thanh01pmt/Alphabot/HW/Alphabot 2.pptx

## Alphabot 2.0

By Melvin & Noah

## Slide 2

Schnupperlehrvariante / Grundbestückung

Speisung
- Powerboost
- Batterie
- Power ON LED
- ON/OFF Switch

Kontrolleinheit
ESP32 / Arduino Nano

Motor
- Motor
- Treiber
- Räder
- Stromregelung

Input
- IR-Linienfolger
- (IR-Distanz)
- (Endschalter)
- (Ultraschall)

= Grundbestückung

Output
- Test-Led
- Bodenbeleuchtung WS2812B
- («Mund»)

Extra
- 4x7 Matrix
- 5 Taster

= Optional

= Extra

## Slide 3

Fortgeschritten

Taster
3 Stk.

Piezo

Auto
Grundbestückung

Display

Bewegung
ICM-20948

ESP32 CAM

Helligkeit

DIP-Switch
8-Fach

Witterung

= Outputs

= Inputs

= I/O

Sensoren

## Slide 4

Skizze

«Mund»

Endschalter

Endschalter

ESP32

Nano

Display

Treiber

Motor

ICM

Motor

Ladelogik

## Slide 5

Website Auto

CAMx.local

Alphabot 2.0 Control

Camera Stream

Debug Messages

Joystick

X

## Slide 6
