thanh01pmt/Alphabot/HW/Blockdiagramm.pptx

Test-LED

IR-Empfänger

Lichtsensor

WS2812b

Batterie

Piezo

Ultraschall

Umgebung

USB

Speisung

ATmega

I2C

Bewegung

Voltage Translator

USB to UART

Wroom

UART

Serial

Lichtsensor

IR-Empfänger

Test-LED

I/O Expander 1

Taster

IR-Sender

I/O

DIP-Switch

SPI

I/O Expander 2

Motor

Speisung

Low-Bat

Mund/ Endschalter
