thanh01pmt/Alphabot/HW/Blockschaltbild.docx

Data/Wire

Data/Wireless

Power

Joystick

Data

Data

Data

Data

Inputs

Outputs

Joystick

Data

Data

3.3V

3.3V

5V

ESP32 CAM

Website

Stream

Websocket

Steuerung

(Handy / Fernbedienung)

5V

3.7V

IO

ESP32

Websocket

Powerboost

Micro-USB

Lipo Batterie

3.3V Wandler

Motortreiber

Links

Motortreiber

Rechts

Motor Rechts

Motor Links

Blockdiagramm Alphabot 2.0
