thanh01pmt/Alphabot/HW/Einkaufen/Einkaufen.docx

Einkaufen

https://www.dfrobot.com/product-1558.html?search=wheel&description=true&page=3
