thanh01pmt/Alphabot/HW/Einkaufen/OLED_Display.docx

https://www.christians-shop.de/096-OLED-Display-128-x-64-SH1106-I2C-IIC-weiss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

https://www.bastelgarage.ch/oled-display-blau-i2c-128x64-0-96

https://www.makershop.de/display/oled/096-zoll-oled-ssd1306/
