thanh01pmt/Alphabot/HW/Einkaufen/Teure Teile Powerboost.docx

Teure Teile Powerboost

Booster:

https://www.mouser.ch/ProductDetail/Texas-Instruments/TPS61090RSAR?qs=Gse6rAGbi7%2FbGTQiY2PrFA%3D%3D

Battery Management

https://www.mouser.ch/ProductDetail/Microchip-Technology/MCP73871-2CCI-ML?qs=qXsUupcbpXyQfJ2clznZxw%3D%3D

Spule:

https://www.digikey.ch/product-detail/de/bourns-inc/SRN6045-6R8Y/SRN6045-6R8YCT-ND/2756162

Batterieanschluss:

https://www.distrelec.ch/de/stiftleiste-pole-jst-s2b-ph-sm4-tb-lf-sn/p/30021720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

Micro USB:

https://www.digikey.ch/product-detail/de/629105150521/732-5960-1-ND/5047555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

NTC Widerstand:

https://www.mouser.ch/ProductDetail/TDK/NTCG203NH103JTDS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
