thanh01pmt/Alphabot/Kommunikation/CAM Website/Blockdiagramm_CAMWebsite.docx

BLE

Handy3

Handy2

Handy1

Master Handy

ESP-CAM2

ESP-CAM3

ESP-CAM1

Master ESP

Auto1 ESP

Auto2 ESP

Auto3 ESP

UART

WLAN Raspi

Master Website (WLAN)

Website1 (WLAN)

Website2 (WLAN)

Website3 (WLAN)

SPI

Blockdiagramm CAM Webseite
