thanh01pmt/Alphabot/Kommunikation/CAM Website/CAM Webseite.docx

CAM Webseite

Handy

- Verbindet sich mit WLAN Raspi (QR-Code)
- Verbindet sich mit ESP-CAM Website
  - Bekommt Kamerastream
  - Schickt Infos zum ESP-CAM

Auto ESP

- Steuert das Auto
- Schickt Status per BLE zum Master ESP
- Bekommt Infos von:
  - Master ESP (BLE)
  - ESP-CAM (UART)
  - Sensoren

ESP-CAM

- Website
  - Stream
  - Steuerung
- UART zu Auto ESP
  - Infos von Website
  - Infos für Website

Master Handy

- Verbindet sich mit WLAN Raspi (QR-Code)
- Schickt WLAN Raspi Infos für Master ESP
- Bekommt Infos von Master ESP über WLAN Raspi

Master ESP

- Bekommt Infos per BLE von Auto ESP
- Schickt Infos per BLE zu Auto ESP
- Bekommt Infos per SPI von WLAN Raspi
- Schickt Infos per SPI zu WLAN Raspi

WLAN Raspi

- Access Point für Handy zu CAM Kommunikation (Webseite)
- Master Webseite
  - Steuerung von Master Handy zu Master ESP über WLAN Raspi
  - Status von Master ESP zu Master Handy über WLAN Raspi
- SPI zu Master ESP
  - Infos von Website
  - Infos für Website
