thanh01pmt/Alphabot/Kommunikation/CAM WLAN 2/Blockdiagramm_CAMWLAN_V2.docx

Master Handy

Handy3

Handy2

ESP-CAM2

Auto2 ESP

Master ESP

BLE

ESP-CAM3

UART

Auto3 ESP

Handy1

ESP-CAM1

Auto1 ESP

Website1 (WLAN, auf ESP-CAM1)

WLAN ESP

Website2 (WLAN, auf ESP-CAM2)

Website3 (WLAN, auf ESP-CAM3)

Master Website (WLAN)

SPI

Blockdiagramm CAM WLAN V2
