thanh01pmt/Alphabot/Kommunikation/CAM WLAN 2/CAM WLAN V2.docx

CAM WLAN V2

Master ESP

- Bekommt Infos per BLE von Auto ESP
- Schickt Infos per BLE zu Auto ESP
- Bekommt Infos per SPI von WLAN ESP
- Schickt Infos per WLAN zu WLAN ESP

ESP-CAM

- Website
  - Stream
  - Steuerung
- WLAN Hotspot
- UART zu Auto ESP
  - Infos von Website
  - Infos für Website

Handy

- Verbindet sich mit WLAN ESP-CAM (QR-Code)
- Verbindet sich mit ESP-CAM Website
  - Bekommt Kamerastream
  - Schickt Infos zum ESP-CAM

Auto ESP

- Steuert das Auto
- Schickt Status per BLE zum Master ESP
- Bekommt Infos von:
  - Master ESP (BLE)
  - ESP-CAM (UART)
  - Sensoren

WLAN ESP

- Hotspot für Master Handy Kommunikation (Master Webseite)
- Master Webseite
  - Steuerung von Master Handy zu Master ESP über WLAN ESP
  - Status von Master ESP zu Master Handy über WLAN ESP
- SPI zu Master ESP
  - Infos von Website
  - Infos für Website

Master Handy

- Verbindet sich mit WLAN ESP (QR-Code)
- Schickt über WLAN ESP Infos für Master ESP
- Bekommt Infos von Master ESP über WLAN ESP
