thanh01pmt/Alphabot/Kommunikation/CAM WLAN 3/Blockdiagramm_CAMWLAN_V3_Controller.docx

Master Handy

Auto2 ESP

BLE Ev nur Master ESP

UART

Auto1 ESP

WLAN Auto

ESP-CAM2

WLAN ESP

WLAN Controller

Master Website (WLAN)

SPI

HM-18 2.1

Master ESP

ESP-CAM1

WLAN Bildschirm1 (ESP01, Handy)

HM-18 2.2

HM-18 1.2

HM-18 1.1

WLAN Bildschirm2(ESP01, Handy)

Blockdiagramm CAM WLAN V3 Controller
