thanh01pmt/Alphabot/Kommunikation/CAM WLAN 3/Blockdiagramm_CAMWLAN_V3_Handy.docx

Master Handy

Master ESP

BLE

UART

HM-18

Website1 (WLAN, auf ESP-CAM1)

WLAN ESP

Website2 (WLAN, auf ESP-CAM2)

Master Website (WLAN)

SPI

Auto2 ESP

Ev nur Master ESP

Handy2

ESP-CAM2

Handy1

ESP-CAM1

HM-18

Auto1 ESP

Auto

Blockdiagramm CAM WLAN V3 Handy
