thanh01pmt/Alphabot/Kommunikation/CAM WLAN 3/CAM WLAN V3 Handy.docx

CAM WLAN V3 Handy

Auto ESP

- Steuert das Auto
- Schickt Status zum HM18 (Master ESP)
- Bekommt Infos von:
  - HM18 (UART, Master ESP)
  - ESP-CAM (WLAN)
  - Handy (WLAN)
  - Sensoren

Master Handy

- Verbindet sich mit WLAN ESP (QR-Code)
- Schickt über WLAN ESP Infos für Master ESP
- Bekommt Infos von Master ESP über WLAN ESP

Master ESP

- Bekommt Infos per BLE von HM18 (von Auto ESP)
- Schickt Infos per BLE zu HM18 (zu Auto ESP)
- Bekommt Infos per SPI von WLAN ESP
- Schickt Infos per SPI zu WLAN ESP

ESP-CAM

- Website
  - Stream
  - Steuerung

HM18

- Bekommt Infos von Auto ESP (UART) zu Master ESP (BLE)
- Bekommt Infos von Master ESP (BLE) zu Auto ESP (UART

WLAN ESP

- Hotspot für Master Handy Kommunikation (Master Webseite)
- Master Webseite
  - Steuerung von Master Handy zu Master ESP über WLAN ESP
  - Status von Master ESP zu Master Handy über WLAN ESP
- SPI zu Master ESP
  - Infos von Website
  - Infos für Website

Handy

- Verbindet sich mit WLAN (QR-Code)
- Verbindet sich mit Website
  - Bekommt Kamerastream
  - Schickt Infos für das Auto
  - Bekommt Infos vom Auto
