thanh01pmt/Alphabot/Kommunikation/CAM WLAN/Blockdiagramm_CAMWLAN.docx

Handy3

Handy2

ESP-CAM2

Auto2 ESP

Master Handy

Master ESP

BLE

ESP-CAM3

UART

Auto3 ESP

Handy1

ESP-CAM1

Auto1 ESP

Website1 (WLAN, auf ESP-CAM1)

Website2 (WLAN, auf ESP-CAM2)

Website3 (WLAN, auf ESP-CAM3)

Master Website (WLAN)

Blockdiagramm CAM WLAN
