thanh01pmt/Alphabot/Kommunikation/CAM WLAN/CAM WLAN.docx

CAM WLAN

Master ESP

- Bekommt Infos per BLE von Auto ESP
- Schickt Infos per BLE zu Auto ESP
- Bekommt Infos per WLAN von Master Handy
- Schickt Infos per WLAN zu Master Handy
- WLAN Hotspot

ESP-CAM

- Website
  - Stream
  - Steuerung
- WLAN Hotspot
- UART zu Auto ESP
  - Infos von Website
  - Infos für Website

Handy

- Verbindet sich mit WLAN ESP-CAM (QR-Code)
- Verbindet sich mit ESP-CAM Website
  - Bekommt Kamerastream
  - Schickt Infos zum ESP-CAM

Auto ESP

- Steuert das Auto
- Schickt Status per BLE zum Master ESP
- Bekommt Infos von:
  - Master ESP (BLE)
  - ESP-CAM (UART)
  - Sensoren

Master Handy

- Verbindet sich mit WLAN Master ESP (QR-Code)
- Schickt über WLAN Master ESP Infos für Master ESP
- Bekommt Infos von Master ESP über WLAN Master ESP
