thanh01pmt/Alphabot/Kommunikation/QR-Codes/QR-Codes.docx

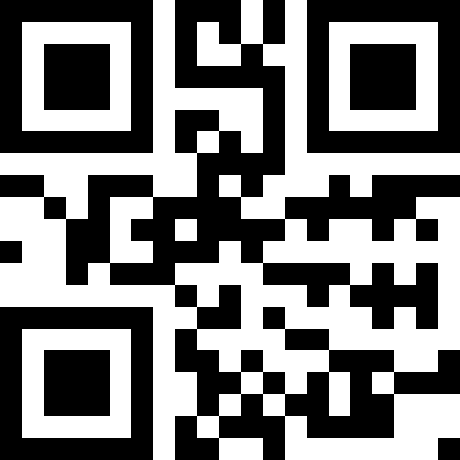
[picture p1: figure]
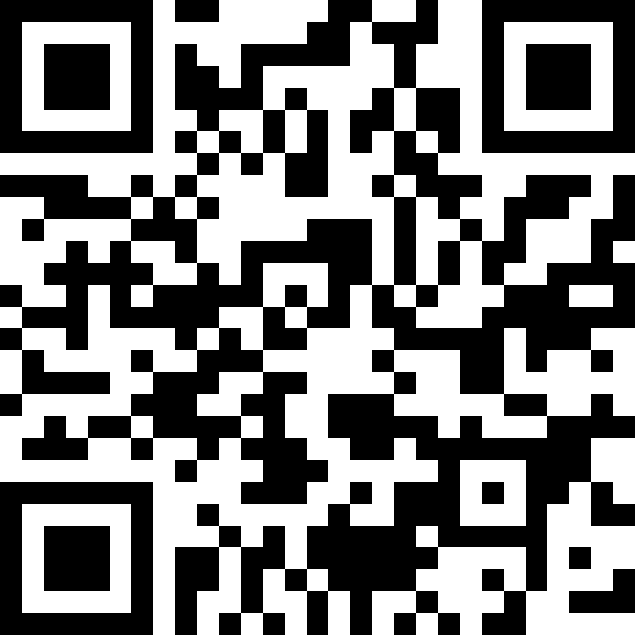
[picture p2: figure]

Wlan: EL-Parcour IP-Adresse Raspberry Pi
