thanh01pmt/Alphabot/Kommunikation/CODE/AUTO/Ablauf.docx

1. Includes
2. Defines
3. Variabeln
4. Initialisierung
5. Funktionen
  a. Motor
  b. convertString
  c. websocket
  d. farbe
  e. convert UDP
6. Setup
  a. Serial.begin
  b. Wifi
  c. Mdns
  d. Rest initialisierung
  e. pinMode
  f. UDP «void»
    i. Call convert UDP
  g. Multicast «i’m here»
  h. Bekommt unicast «Auto x»
  i. Call farbe
7. Loop
  a. Call Motor
  b. Show
  c. …
