thanh01pmt/Alphabot/HW/Datasheets/Pinbelegung_ESP_.PNG

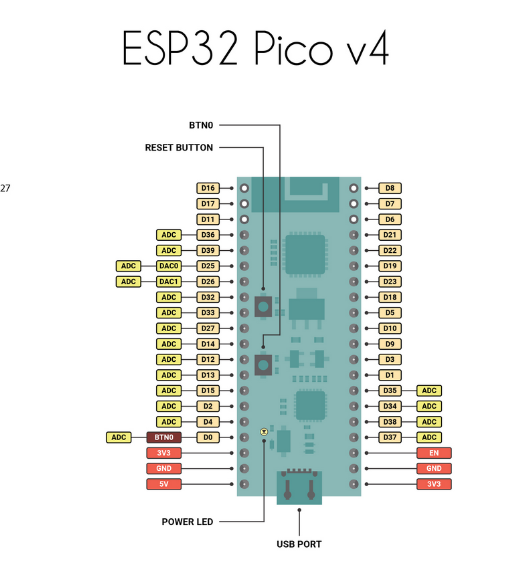
HW/Datasheets/Pinbelegung_ESP_.PNG
