thanh01pmt/Alphabot/HW/Einkaufen/Einkaufen.xlsx

Bestellungen
Bauteil | Art-Nr | Lieferant | Bezeichnung | Preis | Stückzahl | Link
Motor | FIT0579 | dfrobot | DFRobot Micro Metal DC Geared Motor | 7.21 | 14 | https://www.dfrobot.com/product-1736.html?search=fit0579&description=true
Motorhalterung | FIT0160 | dfrobot | Micro Metal Gearmotor Bracket | 3.36 | 7 | https://www.dfrobot.com/product-510.html?search=fit0160&description=true
Räder | FIT0494 | dfrobot | N20 ABS Rubber Wheel 43x9mm | 3.36 | 7 | https://www.dfrobot.com/product-1558.html?search=wheel&description=true&page=3
ESP-32 pico kit | 356-ESP32-PICO-KIT | mouser | WLAN Development Tools | 9.77 | 5 | https://www.mouser.ch/ProductDetail/Espressif-Systems/ESP32-PICO-KIT
Motortreiber | 474-ROB-14451 | mouser | MotorDriver Dual TB6612FNG | 4.84 | 5 | https://www.mouser.ch/ProductDetail/SparkFun/ROB-14451
Powerboost | Powerboost | mouser | PowerBoost 500 Recharge 5V Lipo | 14.62 | 5 | https://www.mouser.ch/ProductDetail/Adafruit/1944
Batterie | 420334 | bastelgarage | LiPo Akku 1500mAh | 10.5 |  | https://www.bastelgarage.ch/lipo-akku-1500mah-jst-2-0-lithium-ion-polymer
WS2812b
IR-Sensor | 11044-350 | distrelec | Reflex coupler | 0.83 | 10 | https://www.distrelec.ch/en/reflex-coupler-30-thd-940-nm-everlight-electronics-itr20001/p/11044350
ON/OFF 2.54 | 485-805 | mouser | Breadboard Friendly SPDT Slide Switch | 0.93 | 10 | https://www.mouser.ch/ProductDetail/Adafruit/805
ESP-CAM | DFR0602 | dfrobot | ESP32-CAM Development Board | 9.52 | 5 | https://www.dfrobot.com/search-esp32-cam.html
Endschalter | MB MICROSWITCH B | reichelt | Me Micro Switch B | 3.57 |  | https://www.reichelt.de/makeblock-me-micro-switch-b-mb-microswitch-b-p202095.html
Widerstände THT
Fredy+Claudio Fragen
Stichsäge | 360544 | brack.ch | Akku-Stichsäge PST 18 LI | 199 | 1 | https://www.brack.ch/bosch-akku-stichsaege-pst-18-li-360544
ruhe | 0.4
fahren ohne widerstnd | 0.5
mit R | 0.6
