thanh01pmt/Alphabot/HW/3D-Druck/Vorderrad/Alphabot2_Vorderrad_oben.stl

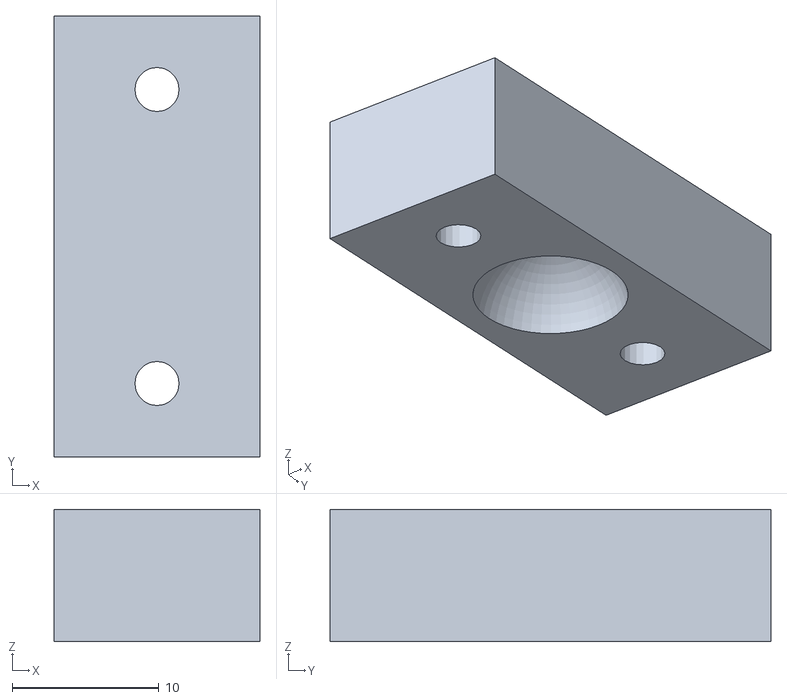
[picture p4: CAD file, 2019-12-18]
HW/3D-Druck/Vorderrad/Alphabot2_Vorderrad_oben.stl
14.0 x 30.0 x 9.00
