thanh01pmt/Alphabot/HW/3D-Druck/Vorderrad/Alphabot2_Vorderrad_unten.stl

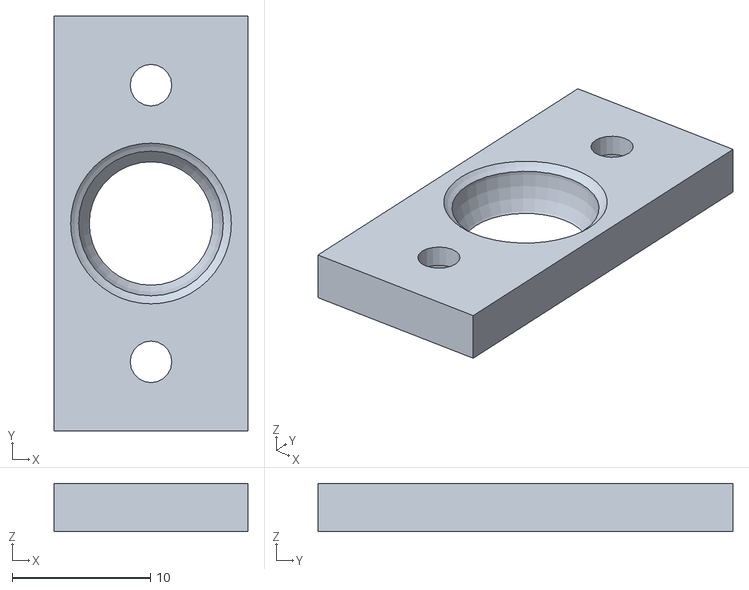
[picture p5: CAD file, 2019-12-18]
HW/3D-Druck/Vorderrad/Alphabot2_Vorderrad_unten.stl
14.0 x 30.0 x 3.50
