thanh01pmt/Alphabot/Kommunikation/Fragen_Problem_Testkriterien.docx

# Fragen/Probleme - Testkriterien:

Cam-Website:

- WLAN Verbindungslimit Raspi?
  - 2 ESP Cams und ein paar andere ESP’s verbinden sich mit dem Raspi Hotspot und simulieren einen starken Datenverkehr, dabei müssen alle Verbindungen aufrechterhalten werden und flüssig bleiben
- ESP Multiconnect?
  - 2 Clients ESP32 Pico Kits kommunizieren mit einem Master ESP32 Wrover Kit über BLE und tauschen verschiedene Daten in beide Richtungen aus
- Raspi WLAN + eigene Website?
  - Hotspot und Apache(Webserver) installieren und die Website über den Hotspot aufrufen
- Kann WLAN Raspi Master ESP ersetzen?
  - Cam Livestream und gleichzeitig BLE Aktivitäten laufen lassen
- Master ESP über BLE oder WLAN?
  - ESP32 WIFI-Cam und Bluetooth Aktivitäten gleichzeitig handeln

Cam-WLAN:

- Gehen 5 WLAN auf kleinstem Raum?
  - Mit ESP’s Hotspots machen und einen starken Datenverkehr simulieren, dabei müssen alle Verbindungen aufrechterhalten werden und flüssig bleiben
- CAM eigener Hotspot und Website?
  - Einen ESP32 Cam programmieren, dass er den Hotspot und die Website gleichzeitig macht
- Auto ESP WLAN und BLE?
  - ESP32 WIFI-Cam und Bluetooth Aktivitäten gleichzeitig handeln
- ESP Multiconnect?
  - 2 Clients ESP32 Pico Kits kommunizieren mit einem Master ESP32 Wrover Kit über BLE und tauschen verschiedene Daten in beide Richtungen aus
