thanh01pmt/Alphabot/(list of files, drawings)

Other design files:
HW/Motorstromüberwachung/Motorstromüberwachung.ms14
