thanh01pmt/Alphabot/HW/Alphabot2.0/Alphabot2.0.kicad_pcb

## KiCad design HW/Alphabot2.0/Alphabot2.0.kicad_pcb (2019-12-18)

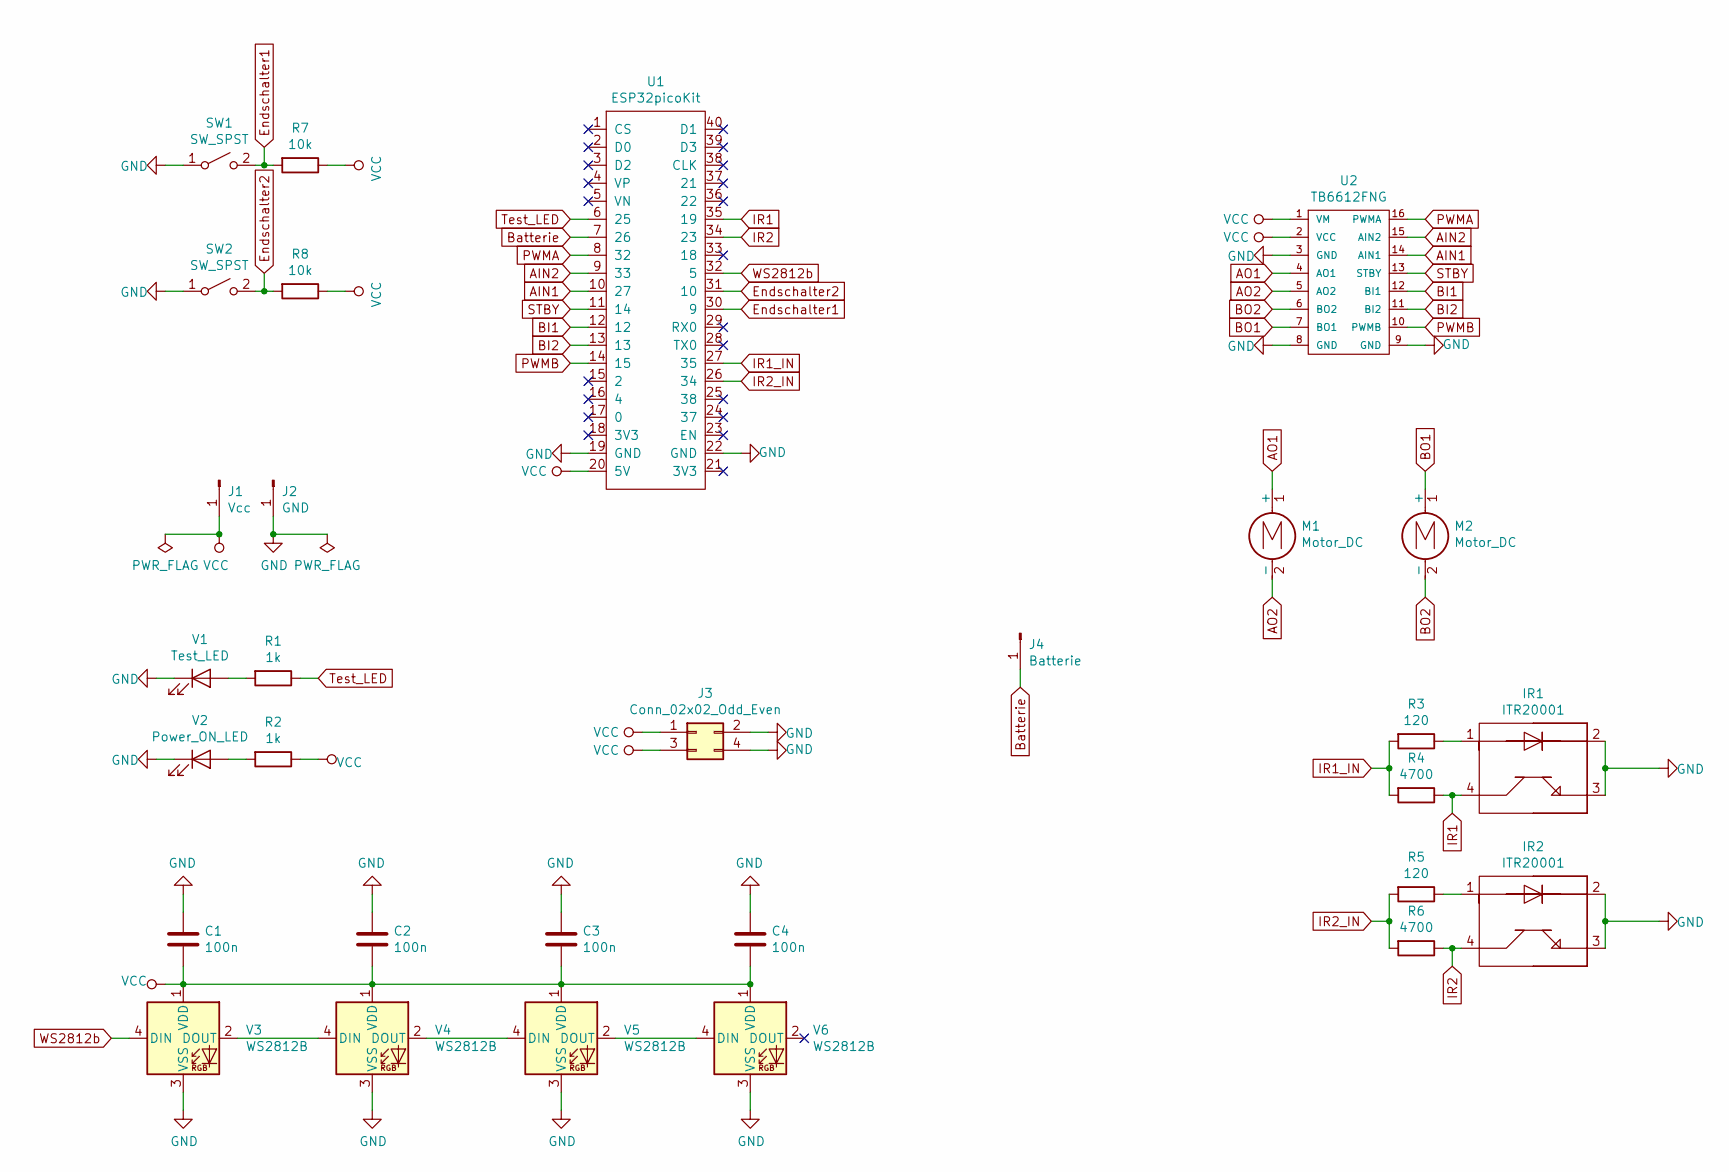
[picture p6: schematic Alphabot2.0.sch, Alphabot2.0]

Parts:
C1, C2, C3, C4: 100n; C_0805_2012Metric_Pad1.15x1.40mm_HandSolder
IR1, IR2: ITR20001; ITR20001-T
J1: Vcc; PinHeader_1x01_P2.54mm_Vertical
J2: GND; PinHeader_1x01_P2.54mm_Vertical
J3: Conn_02x02_Odd_Even; PinHeader_2x02_P2.54mm_Vertical_SMD
J4: Batterie; PinHeader_1x01_P2.54mm_Vertical
M1, M2: Motor_DC; N20_DC_Motor_mit_Halterung
R1, R2: 1k; R_0805_2012Metric_Pad1.15x1.40mm_HandSolder
R3, R5: 120; R_0805_2012Metric_Pad1.15x1.40mm_HandSolder
R4, R6: 4700; R_0805_2012Metric_Pad1.15x1.40mm_HandSolder
R7, R8: 10k; R_0805_2012Metric_Pad1.15x1.40mm_HandSolder
SW1, SW2: SW_SPST; Endschalter
U1: ESP32picoKit; ESP32_Pico_Kit
U2: TB6612FNG
V1: Test_LED; LED_0805_2012Metric_Pad1.15x1.40mm_HandSolder
V2: Power_ON_LED; LED_0805_2012Metric_Pad1.15x1.40mm_HandSolder
V3, V4, V5, V6: WS2812B; LED_WS2812B_PLCC4_5.0x5.0mm_P3.2mm

Connections:
AIN1: U1.10 (27), U2.14 (AIN1)
AIN2: U1.9 (33), U2.15 (AIN2)
AO1: M1.1 (+), U2.4 (AO1)
AO2: M1.2 (-), U2.5 (AO2)
BI1: U1.12, U2.12 (BI1)
BI2: U1.13, U2.11 (BI2)
BO1: M2.1 (+), U2.7 (BO1)
BO2: M2.2 (-), U2.6 (BO2)
Batterie: J4.1, U1.7 (26)
Endschalter1: R7.2, SW1.2 (B), U1.30 (9)
Endschalter2: R8.2, SW2.2 (B), U1.31 (10)
GND: C1.1, C2.1, C3.1, C4.1, IR1.2, IR1.3, IR2.2, IR2.3, J2.1, J3.2, J3.4, SW1.1 (A), SW2.1 (A), U1.19 (GND), U1.22 (GND), U2.3 (GND), U2.8 (GND), U2.9 (GND), V1.1 (K), V2.1 (K), V3.3 (VSS), V4.3 (VSS), V5.3 (VSS), V6.3 (VSS)
IR1: IR1.4, R4.1, U1.35 (19)
IR1_IN: R3.2, R4.2, U1.27 (35)
IR2: IR2.4, R6.1, U1.34 (23)
IR2_IN: R5.2, R6.2, U1.26 (34)
unnamed: IR1.1, R3.1
unnamed: IR2.1, R5.1
unnamed: R1.2, V1.2 (A)
unnamed: R2.2, V2.2 (A)
unnamed: V3.2 (DOUT), V4.4 (DIN)
unnamed: V4.2 (DOUT), V5.4 (DIN)
unnamed: V5.2 (DOUT), V6.4 (DIN)
PWMA: U1.8 (32), U2.16 (PWMA)
PWMB: U1.14 (15), U2.10 (PWMB)
STBY: U1.11 (14), U2.13 (STBY)
Test_LED: R1.1, U1.6 (25)
VCC: C1.2, C2.2, C3.2, C4.2, J1.1, J3.1, J3.3, R2.1, R7.1, R8.1, U1.20 (5V), U2.1 (VM), U2.2 (VCC), V3.1 (VDD), V4.1 (VDD), V5.1 (VDD), V6.1 (VDD)
WS2812b: U1.32 (5), V3.4 (DIN)

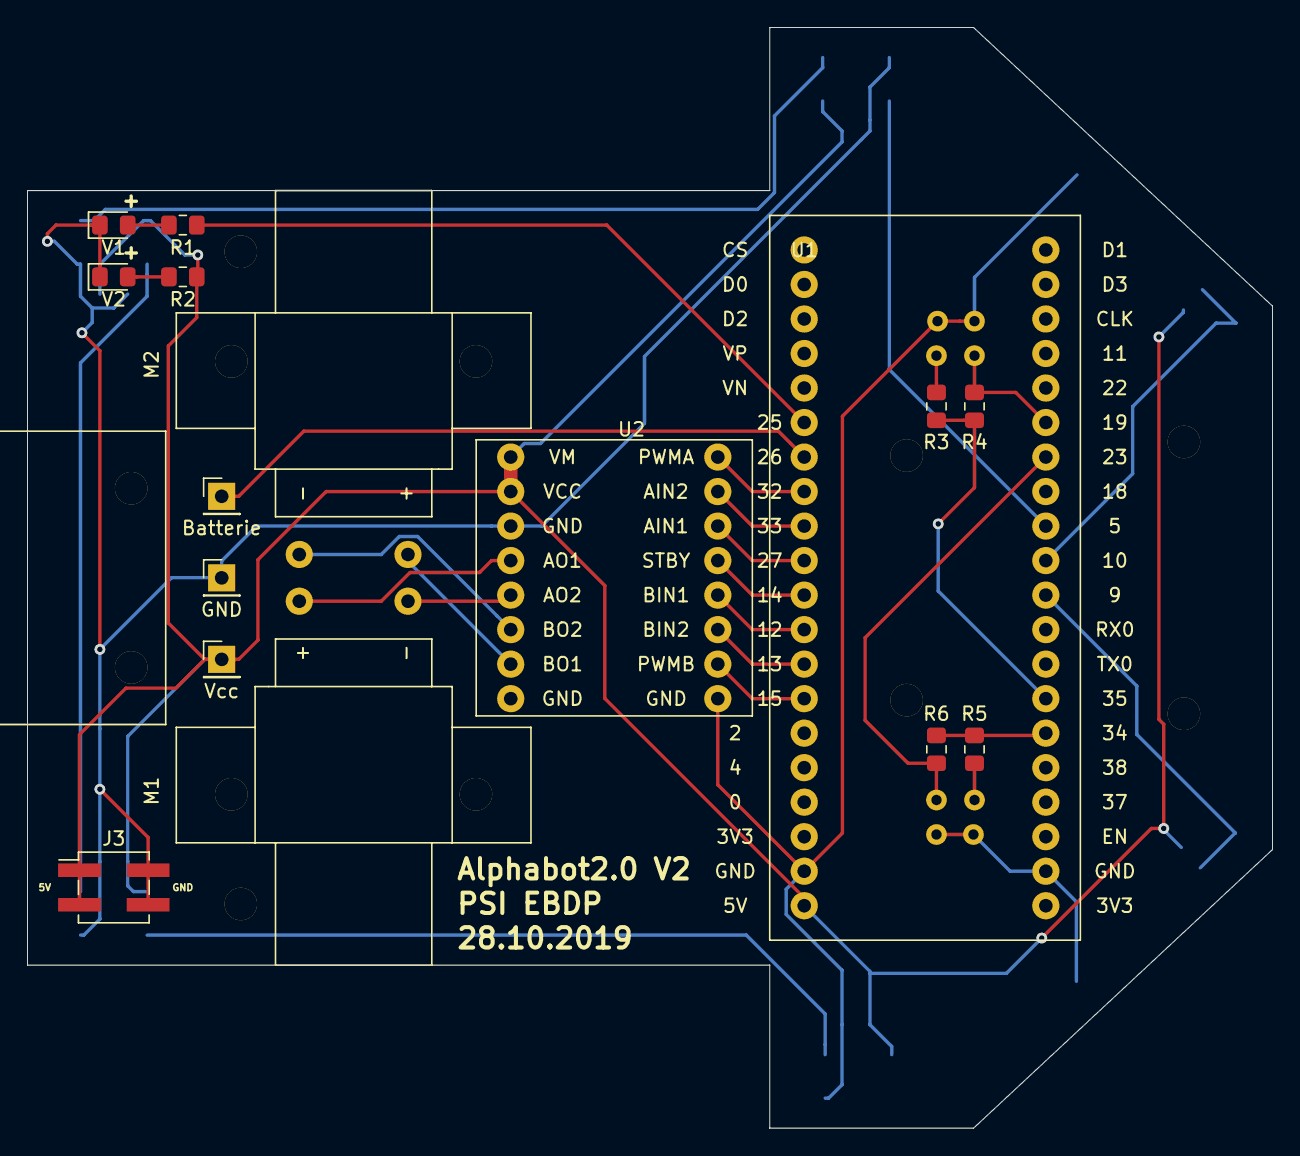
[picture p7: board Alphabot2.0.kicad_pcb from above]

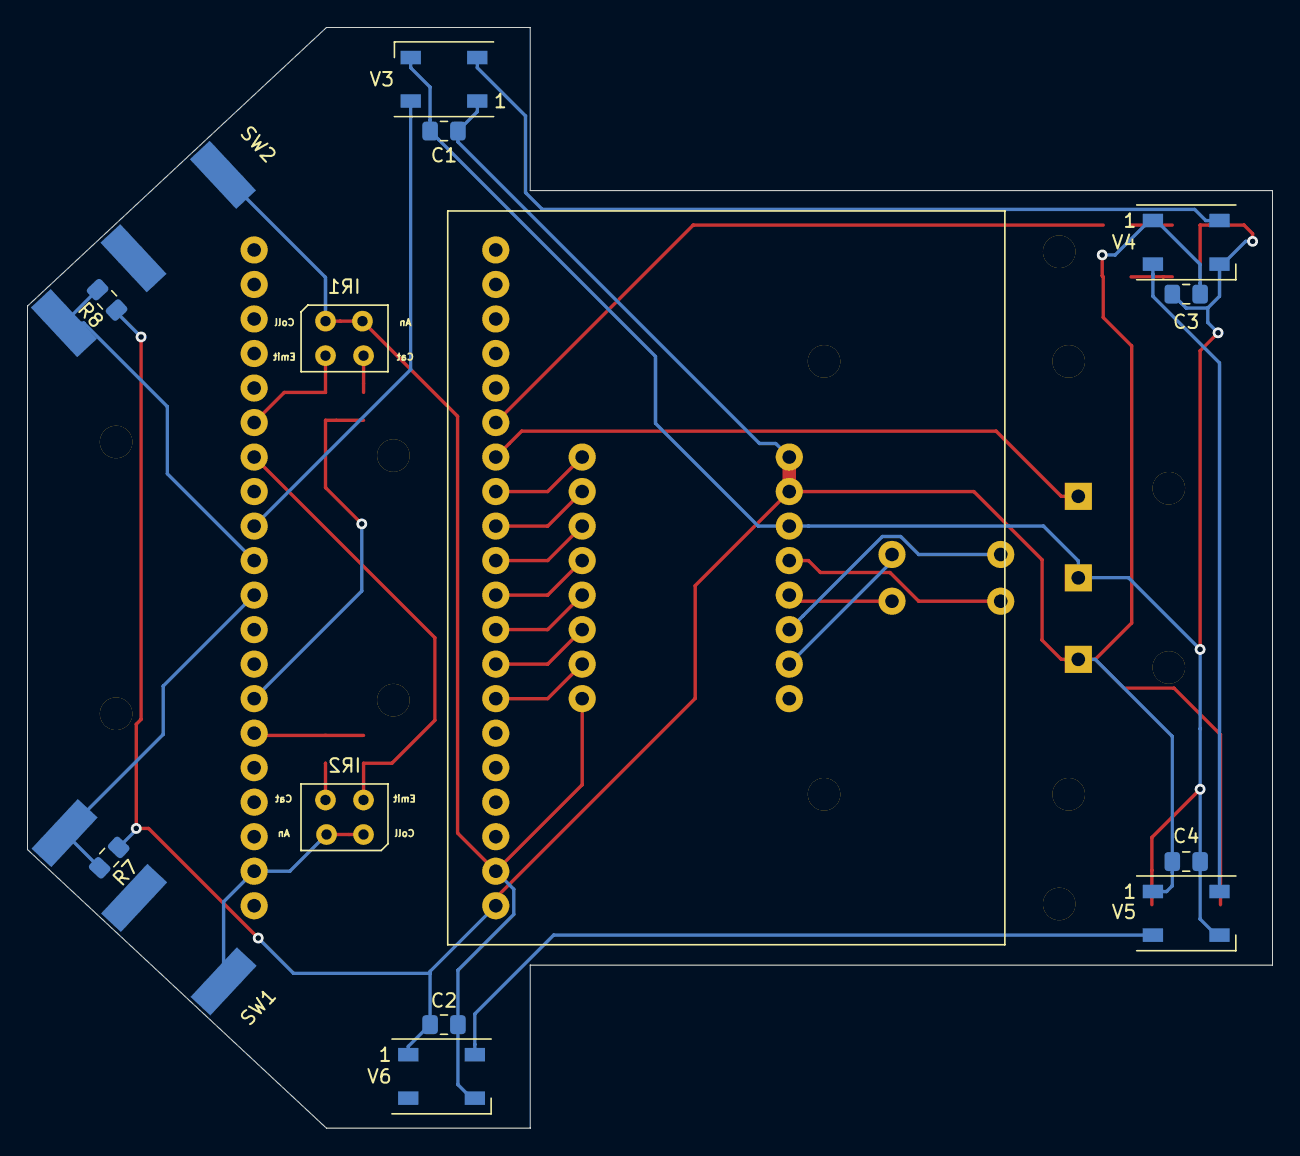
[picture p8: board Alphabot2.0.kicad_pcb from below]

Board: 2 copper layers, 91.6 x 81.0 mm, 30 parts (12 on the bottom side), 29 nets.
