thanh01pmt/Alphabot/Kommunikation/CODE/CAMERA/camera_index.h

//File: index_ov2640.html.gz, Size: 4316
#define index_ov2640_html_gz_len 14080
const uint8_t index_ov2640_html_gz[] = {
  
0x3C,0x21,0x44,0x4F,0x43,0x54,0x59,0x50,0x45,0x20,0x68,0x74,0x6D,0x6C,0x3E,0x0A,0x3C,0x68,0x74,0x6D,0x6C,0x3E,0x0A,0x3C,0x68,0x65,0x61,0x64,0x3E,0x0A,0x09,0x3C,0x74,0x69,0x74,0x6C,0x65,0x3E,0x45,0x53,0x50,0x33,0x32,0x20,0x43,0x41,0x4D,0x3C,0x2F,0x74,0x69,0x74,0x6C,0x65,0x3E,0x0A,0x3C,0x2F,0x68,0x65,0x61,0x64,0x3E,0x0A,0x3C,0x62,0x6F,0x64,0x79,0x3E,0x0A,0x09,0x3C,0x73,0x63,0x72,0x69,0x70,0x74,0x20,0x74,0x79,0x70,0x65,0x3D,0x22,0x74,0x65,0x78,0x74,0x2F,0x6A,0x61,0x76,0x61,0x73,0x63,0x72,0x69,0x70,0x74,0x22,0x3E,0x0A,0x09,0x09,0x76,0x61,0x72,0x20,0x56,0x69,0x72,0x74,0x75,0x61,0x6C,0x4A,0x6F,0x79,0x73,0x74,0x69,0x63,0x6B,0x09,0x3D,0x20,0x66,0x75,0x6E,0x63,0x74,0x69,0x6F,0x6E,0x28,0x6F,0x70,0x74,0x73,0x29,0x0A,0x7B,0x0A,0x09,0x6F,0x70,0x74,0x73,0x09,0x09,0x09,0x3D,0x20,0x6F,0x70,0x74,0x73,0x09,0x09,0x09,0x7C,0x7C,0x20,0x7B,0x7D,0x3B,0x0A,0x09,0x74,0x68,0x69,0x73,0x2E,0x5F,0x63,0x6F,0x6E,0x74,0x61,0x69,0x6E,0x65,0x72,0x09,0x09,0x3D,0x20,0x6F,0x70,0x74,0x73,0x2E,0x63,0x6F,0x6E,0x74,0x61,0x69,0x6E,0x65,0x72,0x09,0x7C,0x7C,0x20,0x64,0x6F,0x63,0x75,0x6D,0x65,0x6E,0x74,0x2E,0x62,0x6F,0x64,0x79,0x3B,0x0A,0x09,0x74,0x68,0x69,0x73,0x2E,0x5F,0x73,0x74,0x72,0x6F,0x6B,0x65,0x53,0x74,0x79,0x6C,0x65,0x09,0x3D,0x20,0x6F,0x70,0x74,0x73,0x2E,0x73,0x74,0x72,0x6F,0x6B,0x65,0x53,0x74,0x79,0x6C,0x65,0x09,0x7C,0x7C,0x20,0x27,0x63,0x79,0x61,0x6E,0x27,0x3B,0x0A,0x09,0x74,0x68,0x69,0x73,0x2E,0x5F,0x73,0x74,0x69,0x63,0x6B,0x45,0x6C,0x09,0x09,0x3D,0x20,0x6F,0x70,0x74,0x73,0x2E,0x73,0x74,0x69,0x63,0x6B,0x45,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

};
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
